readerror67/4esc-by-martinez/4esc-by-martinez/4ESC v3.1.1.brd

## EAGLE design 4esc-by-martinez/4ESC v3.1.1.brd (2013-12-18)

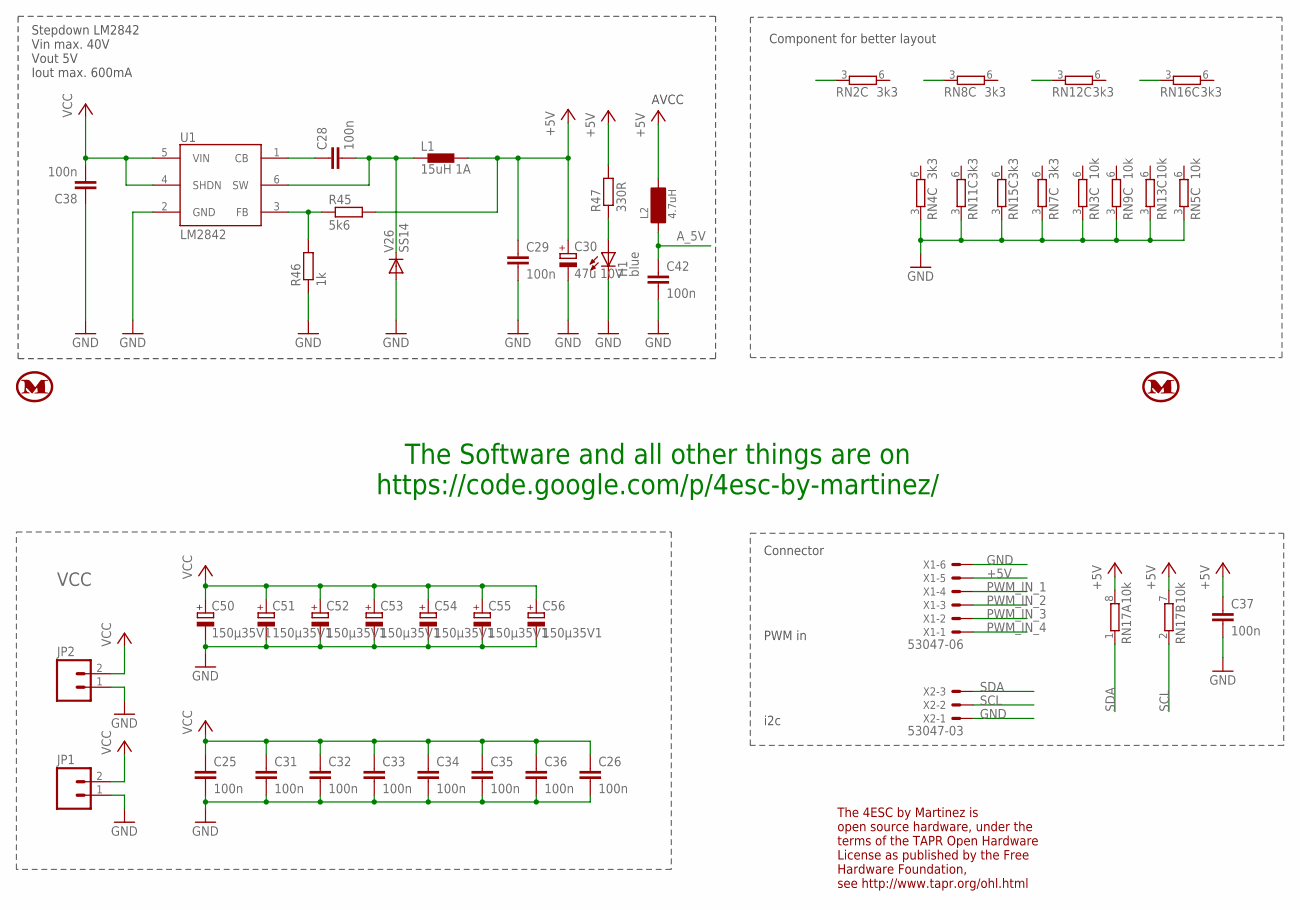
[picture p3: schematic 4ESC v3.1.1.sch, sheet 1]

Parts:
C25, C26, C28, C29, C31, C32, C33, C34, C35, C36, C37, C42: 100n; C0603K
C30: 47u 10V; C/6032-28R
C38: 100n; C1206
C50, C51, C52, C53, C54, C55, C56: 150µ35V1; ELKO_MARTINEZ
H1: blue; CHIPLED_0603
JP1, JP2: M021X02_NO_SILK; 1X02_NO_SILK
L1: 15uH 1A; CDRH4D28
L2: 4.7uH; L0805
R45: 5k6; R0603
R46: 1k; R0603
R47: 330R; R0603
RN2, RN4, RN7, RN8, RN11, RN12, RN15, RN16: 3k3; 4X0402ARV341
RN3, RN5, RN9, RN13, RN17: 10k; 4X0402ARV341
U1: LM2842; SOT23-6
U$1, U$2: M
U$3, U$4: 4ESC_05MM; 4ESC_05MM_HOCH
V26: SS14; DO214AC
X1: 53047-06
X2: 53047-03

Connections:
+5V: C29.1, C30.+, C37.1, L1.P$2 (2), L2.2, R45.2, R47.2, RN17.7 (2), RN17.8 (2), X1.5; also elsewhere on the board
A_5V: C42.1, L2.1; also elsewhere on the board
GND: C25.2, C26.2, C29.2, C30.-, C31.2, C32.2, C33.2, C34.2, C35.2, C36.2, C37.2, C38.1, C42.2, C50.-, C50.-1 (-), C51.-, C51.-1 (-), C52.-, C52.-1 (-), C53.-, C53.-1 (-), C54.-, C54.-1 (-), C55.-, C55.-1 (-), C56.-, C56.-1 (-), H1.C, JP1.1, JP2.1, R46.1, RN3.3 (1), RN4.3 (1), RN5.3 (1), RN7.3 (1), RN9.3 (1), RN11.3 (1), RN13.3 (1), RN15.3 (1), U1.2 (GND), V26.A, X1.6, X2.1; also elsewhere on the board
unnamed: C28.2, L1.P$1 (1), U1.6 (SW), V26.C
unnamed: C28.1, U1.1 (CB)
unnamed: R45.1, R46.2, U1.3 (FB)
unnamed: H1.A, R47.1
PWM_IN_1: X1.4; also elsewhere on the board
PWM_IN_2: X1.3; also elsewhere on the board
PWM_IN_3: X1.2; also elsewhere on the board
PWM_IN_4: X1.1; also elsewhere on the board
SCL: RN17.2 (1), X2.2; also elsewhere on the board
SDA: RN17.1, X2.3; also elsewhere on the board
SENSE_STAR_1: RN2.3 (1); also elsewhere on the board
SENSE_STAR_2: RN8.3 (1); also elsewhere on the board
SENSE_STAR_3: RN12.3 (1); also elsewhere on the board
SENSE_STAR_4: RN16.3 (1); also elsewhere on the board
VCC: C25.1, C26.1, C31.1, C32.1, C33.1, C34.1, C35.1, C36.1, C38.2, C50.+, C50.+1 (+), C51.+, C51.+1 (+), C52.+, C52.+1 (+), C53.+, C53.+1 (+), C54.+, C54.+1 (+), C55.+, C55.+1 (+), C56.+, C56.+1 (+), JP1.2, JP2.2, U1.4 (SHDN), U1.5 (VIN); also elsewhere on the board

Notes on the sheet:
VCC
Stepdown LM2842 Vin max. 40V Vout 5V Iout max. 600mA
Connector PWM in i2c
Component for better layout
AVCC
The 4ESC by Martinez is open source hardware, under the terms of the TAPR Open Hardware License as published by the Free Hardware Foundation, see http://www.tapr.org/ohl.html
The Software and all other things are on https://code.google.com/p/4esc-by-martinez/

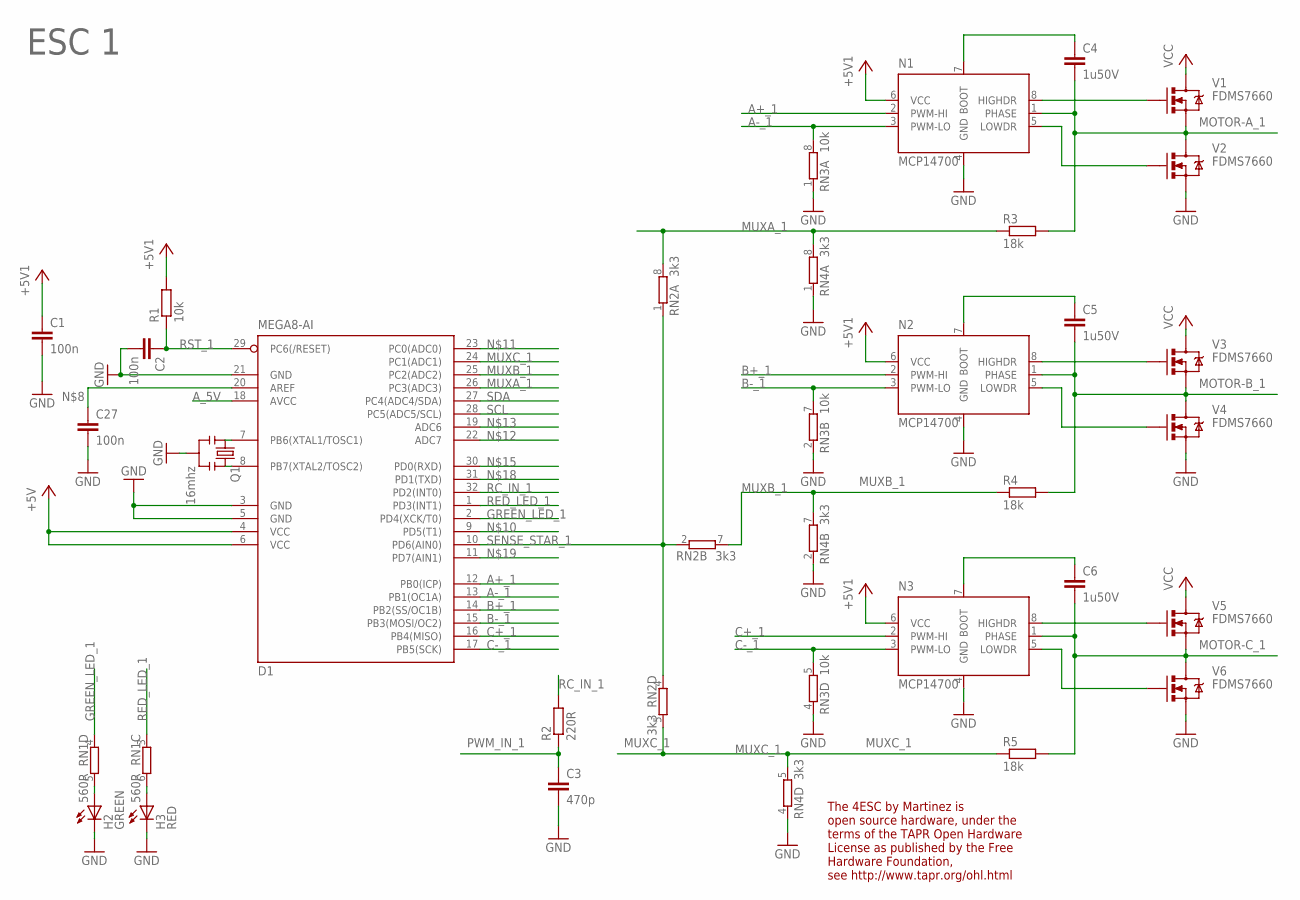
[picture p4: schematic 4ESC v3.1.1.sch, sheet 2]

Parts:
C1, C2, C27: 100n; C0603K
C3: 470p; C0603K
C4, C5, C6: 1u50V; C0805K
D1: MEGA8-AI; TQFP32-08
H2: GREEN; CHIPLED_0603
H3: RED; CHIPLED_0603
N1, N2, N3: MCP14700; DFN3X3P8
Q1: 16mhz; RESONATOR-SMD
R1: 10k; R0603
R2: 220R; R0603
R3, R4, R5: 18k; R0603
RN1: 560R; 4X0402ARV341
RN2, RN4: 3k3; 4X0402ARV341
RN3: 10k; 4X0402ARV341
V1, V2, V3, V4, V5, V6: FDMS7660; POWER56

Connections:
+5V: C1.1, D1.4 (VCC), D1.6 (VCC), N1.6 (VCC), N2.6 (VCC), N3.6 (VCC), R1.2; also elsewhere on the board
A+_1: D1.12 (PB0(ICP)), N1.2 (PWM-HI)
A-_1: D1.13 (PB1(OC1A)), N1.3 (PWM-LO), RN3.8 (2)
A_5V: D1.18 (AVCC); also elsewhere on the board
B+_1: D1.14 (PB2(SS/OC1B)), N2.2 (PWM-HI)
B-_1: D1.15 (PB3(MOSI/OC2)), N2.3 (PWM-LO), RN3.7 (2)
C+_1: D1.16 (PB4(MISO)), N3.2 (PWM-HI)
C-_1: D1.17 (PB5(SCK)), N3.3 (PWM-LO), RN3.5 (2)
GND: C1.2, C2.2, C3.2, C27.2, D1.3 (GND), D1.5 (GND), D1.21 (GND), H2.C, H3.C, N1.4 (GND), N2.4 (GND), N3.4 (GND), Q1.2, RN3.1, RN3.2 (1), RN3.4 (1), RN4.1, RN4.2 (1), RN4.4 (1), V2.P$1 (S), V2.P$2 (S), V2.P$3 (S), V4.P$1 (S), V4.P$2 (S), V4.P$3 (S), V6.P$1 (S), V6.P$2 (S), V6.P$3 (S); also elsewhere on the board
GREEN_LED_1: D1.2 (PD4(XCK/T0)), RN1.4 (1)
MOTOR-A_1: C4.2, N1.1 (PHASE), R3.2, V1.P$1 (S), V1.P$2 (S), V1.P$3 (S), V2.P$5 (D), V2.P$6 (D), V2.P$7 (D), V2.P$8 (D), V2.P$9 (D)
MOTOR-B_1: C5.2, N2.1 (PHASE), R4.2, V3.P$1 (S), V3.P$2 (S), V3.P$3 (S), V4.P$5 (D), V4.P$6 (D), V4.P$7 (D), V4.P$8 (D), V4.P$9 (D)
MOTOR-C_1: C6.2, N3.1 (PHASE), R5.2, V5.P$1 (S), V5.P$2 (S), V5.P$3 (S), V6.P$5 (D), V6.P$6 (D), V6.P$7 (D), V6.P$8 (D), V6.P$9 (D)
MUXA_1: D1.26 (PC3(ADC3)), R3.1, RN2.8 (2), RN4.8 (2)
MUXB_1: D1.25 (PC2(ADC2)), R4.1, RN2.7 (2), RN4.7 (2)
MUXC_1: D1.24 (PC1(ADC1)), R5.1, RN2.5 (2), RN4.5 (2)
unnamed: N1.5 (LOWDR), V2.P$4 (G)
unnamed: N2.5 (LOWDR), V4.P$4 (G)
unnamed: D1.8 (PB7(XTAL2/TOSC2)), Q1.3
unnamed: N3.5 (LOWDR), V6.P$4 (G)
unnamed: D1.7 (PB6(XTAL1/TOSC1)), Q1.1
unnamed: H3.A, RN1.6 (2)
unnamed: H2.A, RN1.5 (2)
unnamed: C27.1, D1.20 (AREF)
unnamed: N1.8 (HIGHDR), V1.P$4 (G)
unnamed: N2.8 (HIGHDR), V3.P$4 (G)
unnamed: N3.8 (HIGHDR), V5.P$4 (G)
unnamed: C4.1, N1.7 (BOOT)
unnamed: C5.1, N2.7 (BOOT)
unnamed: C6.1, N3.7 (BOOT)
PWM_IN_1: C3.1, R2.1; also elsewhere on the board
RC_IN_1: D1.32 (PD2(INT0)), R2.2
RED_LED_1: D1.1 (PD3(INT1)), RN1.3 (1)
RST_1: C2.1, D1.29 (PC6(/RESET)), R1.1
SCL: D1.28 (PC5(ADC5/SCL)); also elsewhere on the board
SDA: D1.27 (PC4(ADC4/SDA)); also elsewhere on the board
SENSE_STAR_1: D1.10 (PD6(AIN0)), RN2.1, RN2.2 (1), RN2.4 (1); also elsewhere on the board
VCC: V1.P$5 (D), V1.P$6 (D), V1.P$7 (D), V1.P$8 (D), V1.P$9 (D), V3.P$5 (D), V3.P$6 (D), V3.P$7 (D), V3.P$8 (D), V3.P$9 (D), V5.P$5 (D), V5.P$6 (D), V5.P$7 (D), V5.P$8 (D), V5.P$9 (D); also elsewhere on the board

Notes on the sheet:
ESC 1
The 4ESC by Martinez is open source hardware, under the terms of the TAPR Open Hardware License as published by the Free Hardware Foundation, see http://www.tapr.org/ohl.html

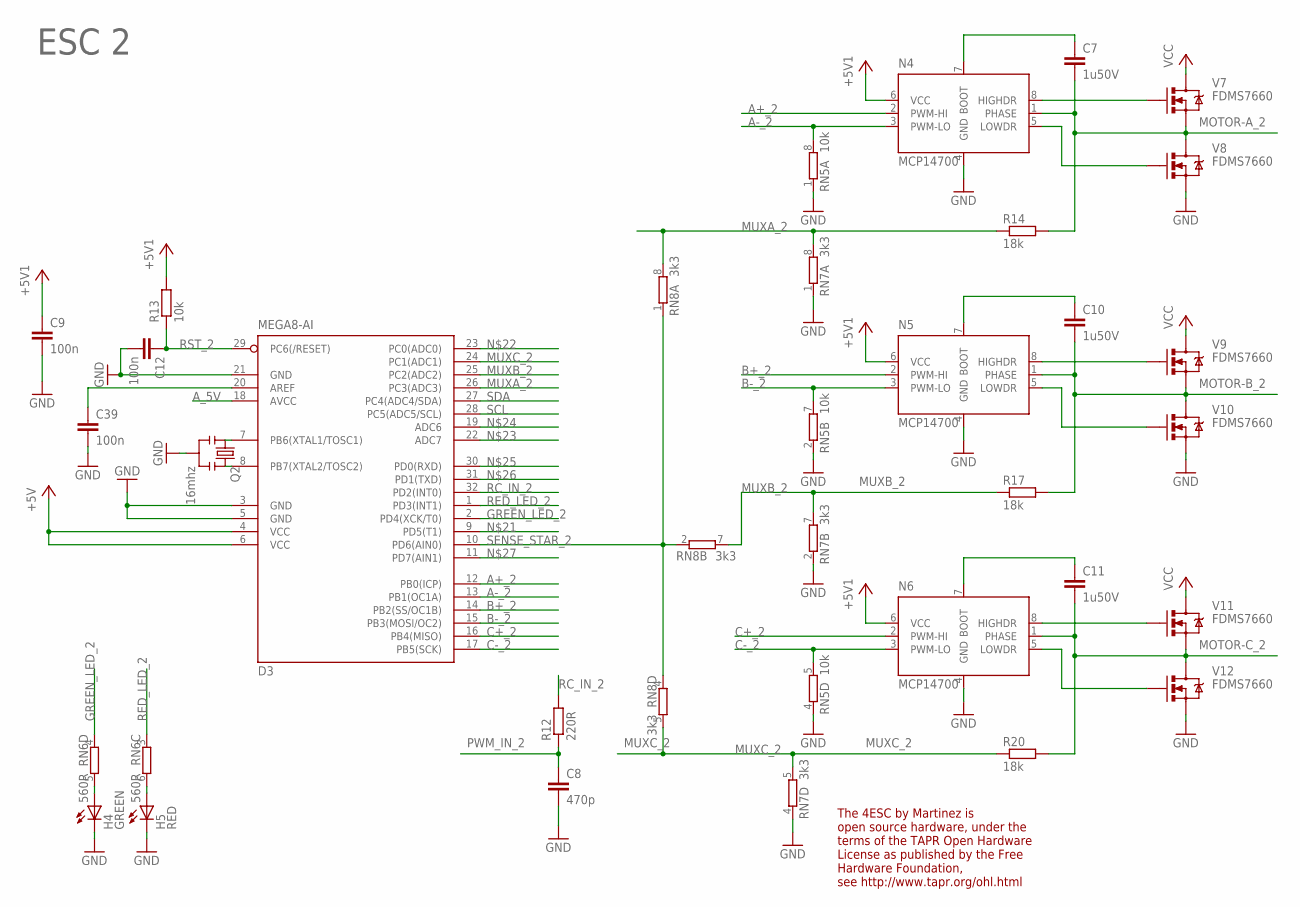
[picture p5: schematic 4ESC v3.1.1.sch, sheet 3]

Parts:
C7, C10, C11: 1u50V; C0805K
C8: 470p; C0603K
C9, C12, C39: 100n; C0603K
D3: MEGA8-AI; TQFP32-08
H4: GREEN; CHIPLED_0603
H5: RED; CHIPLED_0603
N4, N5, N6: MCP14700; DFN3X3P8
Q2: 16mhz; RESONATOR-SMD
R12: 220R; R0603
R13: 10k; R0603
R14, R17, R20: 18k; R0603
RN5: 10k; 4X0402ARV341
RN6: 560R; 4X0402ARV341
RN7, RN8: 3k3; 4X0402ARV341
V7, V8, V9, V10, V11, V12: FDMS7660; POWER56

Connections:
+5V: C9.1, D3.4 (VCC), D3.6 (VCC), N4.6 (VCC), N5.6 (VCC), N6.6 (VCC), R13.2; also elsewhere on the board
A+_2: D3.12 (PB0(ICP)), N4.2 (PWM-HI)
A-_2: D3.13 (PB1(OC1A)), N4.3 (PWM-LO), RN5.8 (2)
A_5V: D3.18 (AVCC); also elsewhere on the board
B+_2: D3.14 (PB2(SS/OC1B)), N5.2 (PWM-HI)
B-_2: D3.15 (PB3(MOSI/OC2)), N5.3 (PWM-LO), RN5.7 (2)
C+_2: D3.16 (PB4(MISO)), N6.2 (PWM-HI)
C-_2: D3.17 (PB5(SCK)), N6.3 (PWM-LO), RN5.5 (2)
GND: C8.2, C9.2, C12.2, C39.2, D3.3 (GND), D3.5 (GND), D3.21 (GND), H4.C, H5.C, N4.4 (GND), N5.4 (GND), N6.4 (GND), Q2.2, RN5.1, RN5.2 (1), RN5.4 (1), RN7.1, RN7.2 (1), RN7.4 (1), V8.P$1 (S), V8.P$2 (S), V8.P$3 (S), V10.P$1 (S), V10.P$2 (S), V10.P$3 (S), V12.P$1 (S), V12.P$2 (S), V12.P$3 (S); also elsewhere on the board
GREEN_LED_2: D3.2 (PD4(XCK/T0)), RN6.4 (1)
MOTOR-A_2: C7.2, N4.1 (PHASE), R14.2, V7.P$1 (S), V7.P$2 (S), V7.P$3 (S), V8.P$5 (D), V8.P$6 (D), V8.P$7 (D), V8.P$8 (D), V8.P$9 (D)
MOTOR-B_2: C10.2, N5.1 (PHASE), R17.2, V9.P$1 (S), V9.P$2 (S), V9.P$3 (S), V10.P$5 (D), V10.P$6 (D), V10.P$7 (D), V10.P$8 (D), V10.P$9 (D)
MOTOR-C_2: C11.2, N6.1 (PHASE), R20.2, V11.P$1 (S), V11.P$2 (S), V11.P$3 (S), V12.P$5 (D), V12.P$6 (D), V12.P$7 (D), V12.P$8 (D), V12.P$9 (D)
MUXA_2: D3.26 (PC3(ADC3)), R14.1, RN7.8 (2), RN8.8 (2)
MUXB_2: D3.25 (PC2(ADC2)), R17.1, RN7.7 (2), RN8.7 (2)
MUXC_2: D3.24 (PC1(ADC1)), R20.1, RN7.5 (2), RN8.5 (2)
unnamed: D3.8 (PB7(XTAL2/TOSC2)), Q2.3
unnamed: D3.7 (PB6(XTAL1/TOSC1)), Q2.1
unnamed: N4.5 (LOWDR), V8.P$4 (G)
unnamed: N5.5 (LOWDR), V10.P$4 (G)
unnamed: N6.5 (LOWDR), V12.P$4 (G)
unnamed: H4.A, RN6.5 (2)
unnamed: N4.8 (HIGHDR), V7.P$4 (G)
unnamed: N5.8 (HIGHDR), V9.P$4 (G)
unnamed: N6.8 (HIGHDR), V11.P$4 (G)
unnamed: C39.1, D3.20 (AREF)
unnamed: H5.A, RN6.6 (2)
unnamed: C7.1, N4.7 (BOOT)
unnamed: C10.1, N5.7 (BOOT)
unnamed: C11.1, N6.7 (BOOT)
PWM_IN_2: C8.1, R12.1; also elsewhere on the board
RC_IN_2: D3.32 (PD2(INT0)), R12.2
RED_LED_2: D3.1 (PD3(INT1)), RN6.3 (1)
RST_2: C12.1, D3.29 (PC6(/RESET)), R13.1
SCL: D3.28 (PC5(ADC5/SCL)); also elsewhere on the board
SDA: D3.27 (PC4(ADC4/SDA)); also elsewhere on the board
SENSE_STAR_2: D3.10 (PD6(AIN0)), RN8.1, RN8.2 (1), RN8.4 (1); also elsewhere on the board
VCC: V7.P$5 (D), V7.P$6 (D), V7.P$7 (D), V7.P$8 (D), V7.P$9 (D), V9.P$5 (D), V9.P$6 (D), V9.P$7 (D), V9.P$8 (D), V9.P$9 (D), V11.P$5 (D), V11.P$6 (D), V11.P$7 (D), V11.P$8 (D), V11.P$9 (D); also elsewhere on the board

Notes on the sheet:
ESC 2
The 4ESC by Martinez is open source hardware, under the terms of the TAPR Open Hardware License as published by the Free Hardware Foundation, see http://www.tapr.org/ohl.html

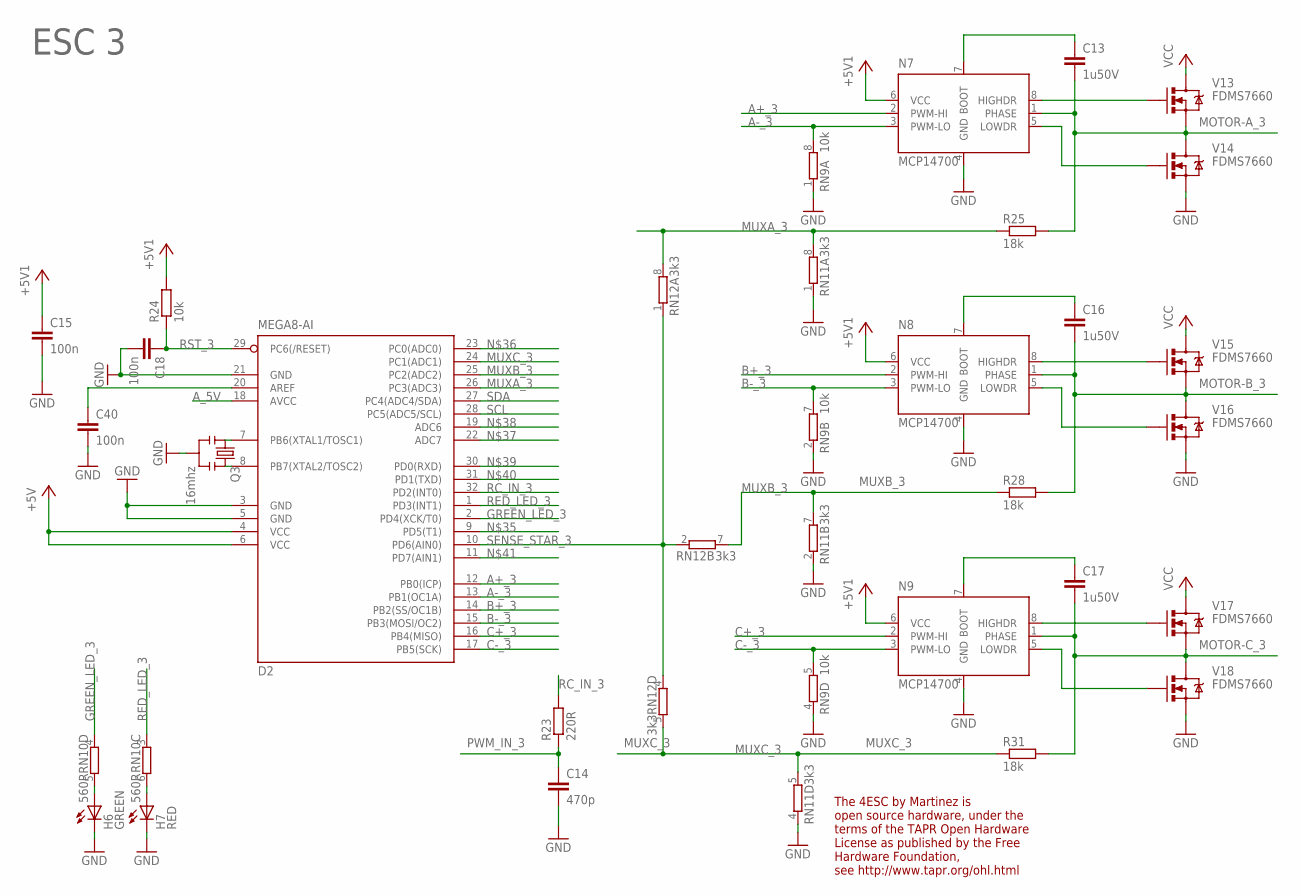
[picture p6: schematic 4ESC v3.1.1.sch, sheet 4]

Parts:
C13, C16, C17: 1u50V; C0805K
C14: 470p; C0603K
C15, C18, C40: 100n; C0603K
D2: MEGA8-AI; TQFP32-08
H6: GREEN; CHIPLED_0603
H7: RED; CHIPLED_0603
N7, N8, N9: MCP14700; DFN3X3P8
Q3: 16mhz; RESONATOR-SMD
R23: 220R; R0603
R24: 10k; R0603
R25, R28, R31: 18k; R0603
RN9: 10k; 4X0402ARV341
RN10: 560R; 4X0402ARV341
RN11, RN12: 3k3; 4X0402ARV341
V13, V14, V15, V16, V17, V18: FDMS7660; POWER56

Connections:
+5V: C15.1, D2.4 (VCC), D2.6 (VCC), N7.6 (VCC), N8.6 (VCC), N9.6 (VCC), R24.2; also elsewhere on the board
A+_3: D2.12 (PB0(ICP)), N7.2 (PWM-HI)
A-_3: D2.13 (PB1(OC1A)), N7.3 (PWM-LO), RN9.8 (2)
A_5V: D2.18 (AVCC); also elsewhere on the board
B+_3: D2.14 (PB2(SS/OC1B)), N8.2 (PWM-HI)
B-_3: D2.15 (PB3(MOSI/OC2)), N8.3 (PWM-LO), RN9.7 (2)
C+_3: D2.16 (PB4(MISO)), N9.2 (PWM-HI)
C-_3: D2.17 (PB5(SCK)), N9.3 (PWM-LO), RN9.5 (2)
GND: C14.2, C15.2, C18.2, C40.2, D2.3 (GND), D2.5 (GND), D2.21 (GND), H6.C, H7.C, N7.4 (GND), N8.4 (GND), N9.4 (GND), Q3.2, RN9.1, RN9.2 (1), RN9.4 (1), RN11.1, RN11.2 (1), RN11.4 (1), V14.P$1 (S), V14.P$2 (S), V14.P$3 (S), V16.P$1 (S), V16.P$2 (S), V16.P$3 (S), V18.P$1 (S), V18.P$2 (S), V18.P$3 (S); also elsewhere on the board
GREEN_LED_3: D2.2 (PD4(XCK/T0)), RN10.4 (1)
MOTOR-A_3: C13.2, N7.1 (PHASE), R25.2, V13.P$1 (S), V13.P$2 (S), V13.P$3 (S), V14.P$5 (D), V14.P$6 (D), V14.P$7 (D), V14.P$8 (D), V14.P$9 (D)
MOTOR-B_3: C16.2, N8.1 (PHASE), R28.2, V15.P$1 (S), V15.P$2 (S), V15.P$3 (S), V16.P$5 (D), V16.P$6 (D), V16.P$7 (D), V16.P$8 (D), V16.P$9 (D)
MOTOR-C_3: C17.2, N9.1 (PHASE), R31.2, V17.P$1 (S), V17.P$2 (S), V17.P$3 (S), V18.P$5 (D), V18.P$6 (D), V18.P$7 (D), V18.P$8 (D), V18.P$9 (D)
MUXA_3: D2.26 (PC3(ADC3)), R25.1, RN11.8 (2), RN12.8 (2)
MUXB_3: D2.25 (PC2(ADC2)), R28.1, RN11.7 (2), RN12.7 (2)
MUXC_3: D2.24 (PC1(ADC1)), R31.1, RN11.5 (2), RN12.5 (2)
unnamed: D2.8 (PB7(XTAL2/TOSC2)), Q3.3
unnamed: D2.7 (PB6(XTAL1/TOSC1)), Q3.1
unnamed: C40.1, D2.20 (AREF)
unnamed: N7.8 (HIGHDR), V13.P$4 (G)
unnamed: N8.8 (HIGHDR), V15.P$4 (G)
unnamed: N9.8 (HIGHDR), V17.P$4 (G)
unnamed: N7.5 (LOWDR), V14.P$4 (G)
unnamed: N8.5 (LOWDR), V16.P$4 (G)
unnamed: N9.5 (LOWDR), V18.P$4 (G)
unnamed: H6.A, RN10.5 (2)
unnamed: H7.A, RN10.6 (2)
unnamed: C13.1, N7.7 (BOOT)
unnamed: C16.1, N8.7 (BOOT)
unnamed: C17.1, N9.7 (BOOT)
PWM_IN_3: C14.1, R23.1; also elsewhere on the board
RC_IN_3: D2.32 (PD2(INT0)), R23.2
RED_LED_3: D2.1 (PD3(INT1)), RN10.3 (1)
RST_3: C18.1, D2.29 (PC6(/RESET)), R24.1
SCL: D2.28 (PC5(ADC5/SCL)); also elsewhere on the board
SDA: D2.27 (PC4(ADC4/SDA)); also elsewhere on the board
SENSE_STAR_3: D2.10 (PD6(AIN0)), RN12.1, RN12.2 (1), RN12.4 (1); also elsewhere on the board
VCC: V13.P$5 (D), V13.P$6 (D), V13.P$7 (D), V13.P$8 (D), V13.P$9 (D), V15.P$5 (D), V15.P$6 (D), V15.P$7 (D), V15.P$8 (D), V15.P$9 (D), V17.P$5 (D), V17.P$6 (D), V17.P$7 (D), V17.P$8 (D), V17.P$9 (D); also elsewhere on the board

Notes on the sheet:
ESC 3
The 4ESC by Martinez is open source hardware, under the terms of the TAPR Open Hardware License as published by the Free Hardware Foundation, see http://www.tapr.org/ohl.html

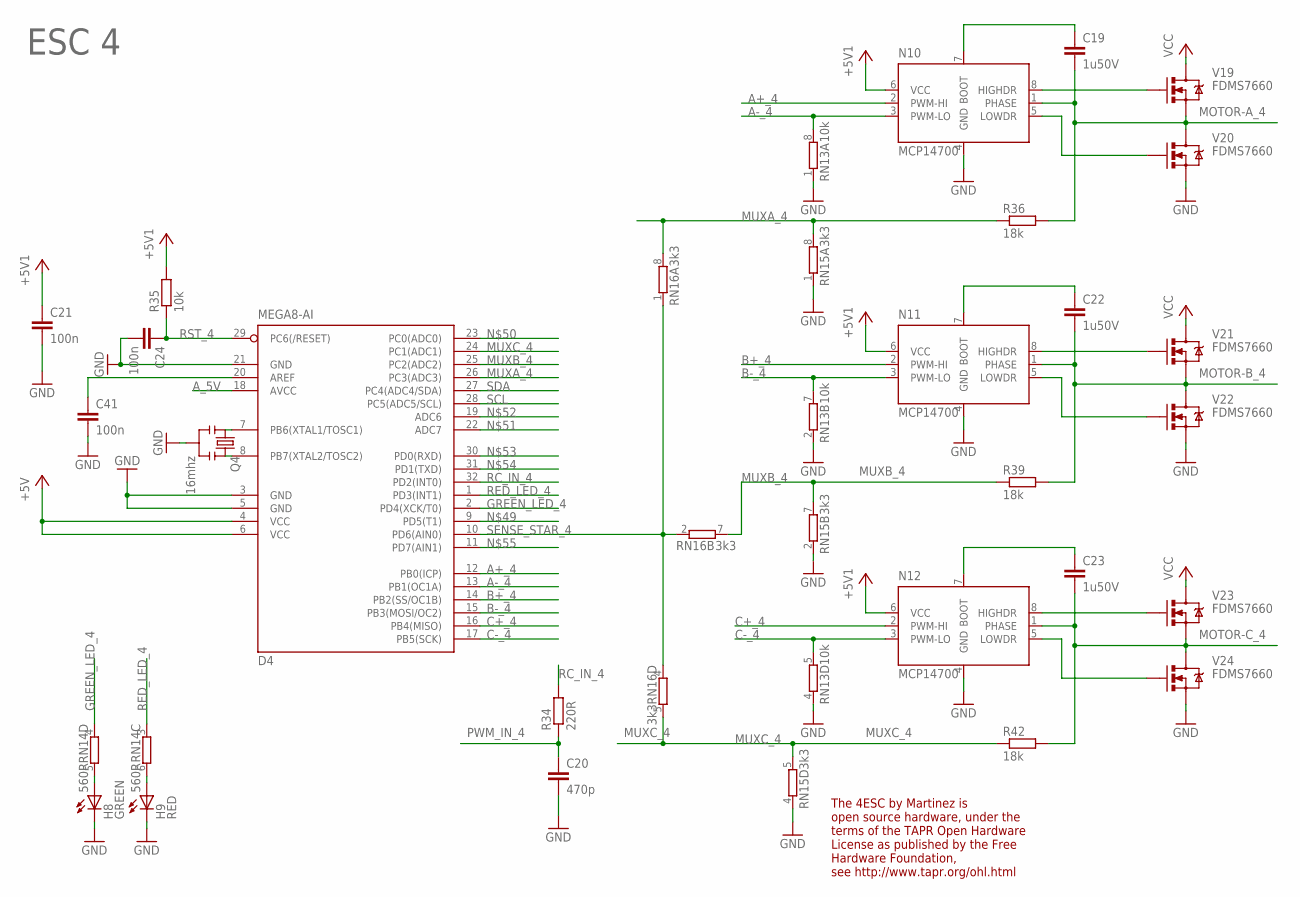
[picture p7: schematic 4ESC v3.1.1.sch, sheet 5]

Parts:
C19, C22, C23: 1u50V; C0805K
C20: 470p; C0603K
C21, C24, C41: 100n; C0603K
D4: MEGA8-AI; TQFP32-08
H8: GREEN; CHIPLED_0603
H9: RED; CHIPLED_0603
N10, N11, N12: MCP14700; DFN3X3P8
Q4: 16mhz; RESONATOR-SMD
R34: 220R; R0603
R35: 10k; R0603
R36, R39, R42: 18k; R0603
RN13: 10k; 4X0402ARV341
RN14: 560R; 4X0402ARV341
RN15, RN16: 3k3; 4X0402ARV341
V19, V20, V21, V22, V23, V24: FDMS7660; POWER56

Connections:
+5V: C21.1, D4.4 (VCC), D4.6 (VCC), N10.6 (VCC), N11.6 (VCC), N12.6 (VCC), R35.2; also elsewhere on the board
A+_4: D4.12 (PB0(ICP)), N10.2 (PWM-HI)
A-_4: D4.13 (PB1(OC1A)), N10.3 (PWM-LO), RN13.8 (2)
A_5V: D4.18 (AVCC); also elsewhere on the board
B+_4: D4.14 (PB2(SS/OC1B)), N11.2 (PWM-HI)
B-_4: D4.15 (PB3(MOSI/OC2)), N11.3 (PWM-LO), RN13.7 (2)
C+_4: D4.16 (PB4(MISO)), N12.2 (PWM-HI)
C-_4: D4.17 (PB5(SCK)), N12.3 (PWM-LO), RN13.5 (2)
GND: C20.2, C21.2, C24.2, C41.2, D4.3 (GND), D4.5 (GND), D4.21 (GND), H8.C, H9.C, N10.4 (GND), N11.4 (GND), N12.4 (GND), Q4.2, RN13.1, RN13.2 (1), RN13.4 (1), RN15.1, RN15.2 (1), RN15.4 (1), V20.P$1 (S), V20.P$2 (S), V20.P$3 (S), V22.P$1 (S), V22.P$2 (S), V22.P$3 (S), V24.P$1 (S), V24.P$2 (S), V24.P$3 (S); also elsewhere on the board
GREEN_LED_4: D4.2 (PD4(XCK/T0)), RN14.4 (1)
MOTOR-A_4: C19.2, N10.1 (PHASE), R36.2, V19.P$1 (S), V19.P$2 (S), V19.P$3 (S), V20.P$5 (D), V20.P$6 (D), V20.P$7 (D), V20.P$8 (D), V20.P$9 (D)
MOTOR-B_4: C22.2, N11.1 (PHASE), R39.2, V21.P$1 (S), V21.P$2 (S), V21.P$3 (S), V22.P$5 (D), V22.P$6 (D), V22.P$7 (D), V22.P$8 (D), V22.P$9 (D)
MOTOR-C_4: C23.2, N12.1 (PHASE), R42.2, V23.P$1 (S), V23.P$2 (S), V23.P$3 (S), V24.P$5 (D), V24.P$6 (D), V24.P$7 (D), V24.P$8 (D), V24.P$9 (D)
MUXA_4: D4.26 (PC3(ADC3)), R36.1, RN15.8 (2), RN16.8 (2)
MUXB_4: D4.25 (PC2(ADC2)), R39.1, RN15.7 (2), RN16.7 (2)
MUXC_4: D4.24 (PC1(ADC1)), R42.1, RN15.5 (2), RN16.5 (2)
unnamed: D4.8 (PB7(XTAL2/TOSC2)), Q4.3
unnamed: D4.7 (PB6(XTAL1/TOSC1)), Q4.1
unnamed: N10.8 (HIGHDR), V19.P$4 (G)
unnamed: N11.8 (HIGHDR), V21.P$4 (G)
unnamed: N12.8 (HIGHDR), V23.P$4 (G)
unnamed: C41.1, D4.20 (AREF)
unnamed: N10.5 (LOWDR), V20.P$4 (G)
unnamed: N11.5 (LOWDR), V22.P$4 (G)
unnamed: N12.5 (LOWDR), V24.P$4 (G)
unnamed: H8.A, RN14.5 (2)
unnamed: H9.A, RN14.6 (2)
unnamed: C19.1, N10.7 (BOOT)
unnamed: C22.1, N11.7 (BOOT)
unnamed: C23.1, N12.7 (BOOT)
PWM_IN_4: C20.1, R34.1; also elsewhere on the board
RC_IN_4: D4.32 (PD2(INT0)), R34.2
RED_LED_4: D4.1 (PD3(INT1)), RN14.3 (1)
RST_4: C24.1, D4.29 (PC6(/RESET)), R35.1
SCL: D4.28 (PC5(ADC5/SCL)); also elsewhere on the board
SDA: D4.27 (PC4(ADC4/SDA)); also elsewhere on the board
SENSE_STAR_4: D4.10 (PD6(AIN0)), RN16.1, RN16.2 (1), RN16.4 (1); also elsewhere on the board
VCC: V19.P$5 (D), V19.P$6 (D), V19.P$7 (D), V19.P$8 (D), V19.P$9 (D), V21.P$5 (D), V21.P$6 (D), V21.P$7 (D), V21.P$8 (D), V21.P$9 (D), V23.P$5 (D), V23.P$6 (D), V23.P$7 (D), V23.P$8 (D), V23.P$9 (D); also elsewhere on the board

Notes on the sheet:
ESC 4
The 4ESC by Martinez is open source hardware, under the terms of the TAPR Open Hardware License as published by the Free Hardware Foundation, see http://www.tapr.org/ohl.html

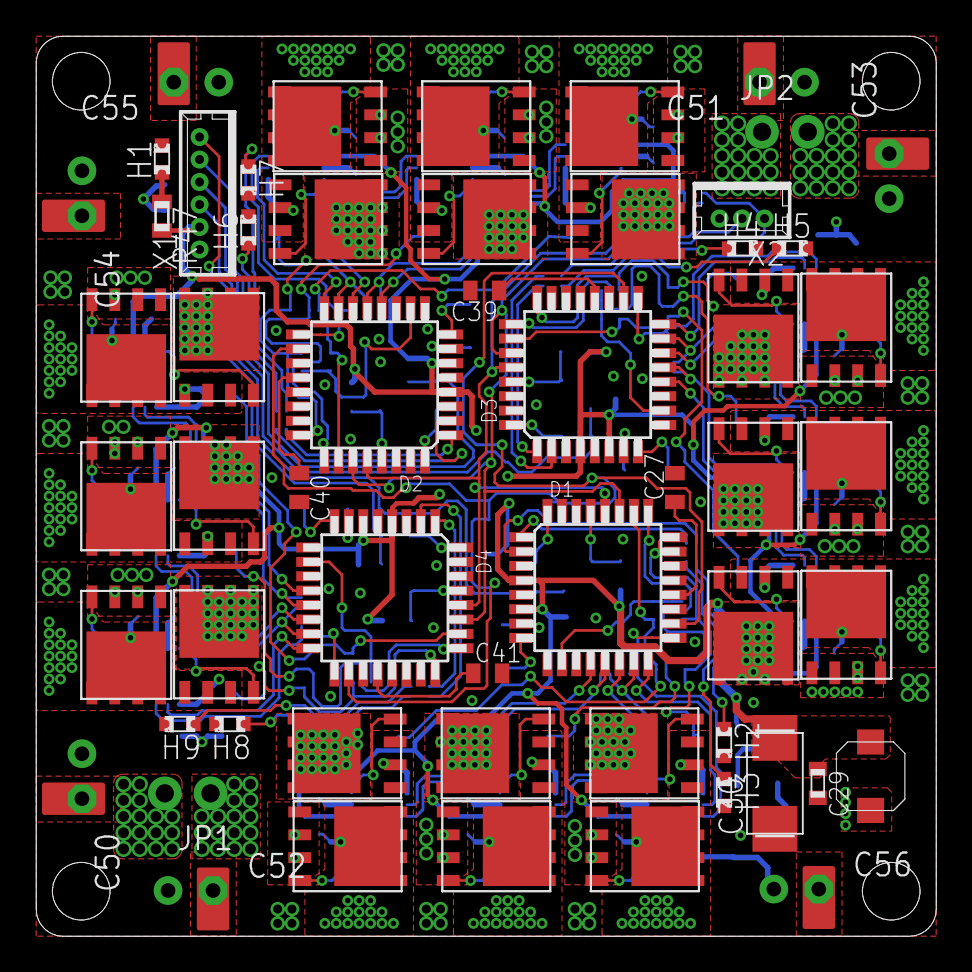
[picture p8: board 4ESC v3.1.1.brd from above]

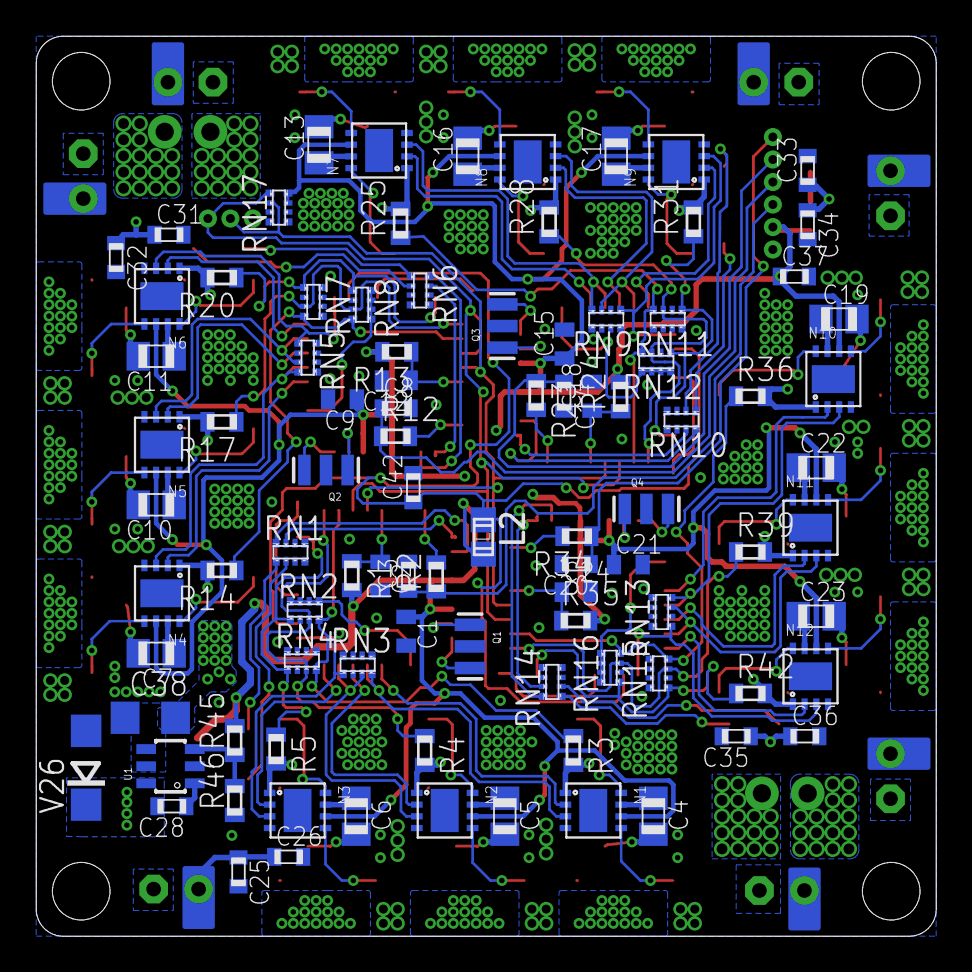
[picture p9: board 4ESC v3.1.1.brd from below]

Board: 4 copper layers, 50.0 x 50.0 mm, 154 parts (96 on the bottom side), 138 nets.
