readerror67/4esc-by-martinez/(commit log)

2013-11-16 zusätzliche MOTOR_ADVANCE und TIMING_OFFSET eingefügt
2013-11-16 COMP_PWM .if und #if martinezV3 fuer avra eingefuegt
2013-11-23 Schrift 4ESC verschoben
    [4ESC v3.1.brd]
2013-12-18 Layout optimiert
    [4ESC v3.1.1.brd, 4ESC v3.1.1.sch]
